Russell501/CDE2310_Group1/mechanical/Turtlebot Center of Mass.xlsx

Group 1: Alexander Yaw Kai Mun (A0306763B), Shandrico (A0305761H), Russell (A0323035U), Moksh (A0305884W)
TurtleBot3 Burger - Mass, CG & MOI Estimation
Origin: Centre of Ball Socket, at ground level. X = Back, Y = Up, Z = Left
Dimensions: 138mm (L) x 178mm (W) x 192mm (H) | Includes Self-Made Payload (Ramp + Launcher + Camera)
No. | Part Name | Qty | Unit Mass (g) | Total Mass (g) | CG X (mm) | CG Y (mm) | CG Z (mm) | Mass*X (g.mm) | Mass*Y (g.mm) | Mass*Z (g.mm) | Top View | Isometric View
1 | Waffle Plate (Layer 1 - Base) with fasteners | 1 | 138.12 | 138.12 | -49.00 | 11.12 | 0.00 | -6767.88 | 1535.89 | 0.00
2 | Waffle Plate (Layer 2) with fasteners | 1 | 138.12 | 138.12 | -49.00 | 48.44 | 0.00 | -6767.88 | 6690.53 | 0.00
3 | Waffle Plate (Layer 3) with fasteners | 1 | 138.12 | 138.12 | -49.00 | 95.22 | 0.00 | -6767.88 | 13151.79 | 0.00
4 | Waffle Plate (Layer 4 - Top) fasteners | 1 | 138.12 | 138.12 | -49.00 | 142.02 | 0.00 | -6767.88 | 19615.80 | 0.00
5 | Dynamixel XL430-W250 (Left Motor) | 1 | 16.00 | 16.00 | -69.00 | 29.08 | 52.67 | -1104.00 | 465.28 | 842.72
6 | Dynamixel XL430-W250 (Right Motor) | 1 | 16.00 | 16.00 | -69.00 | 28.54 | -52.67 | -1104.00 | 456.64 | -842.72
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
