Russell501/CDE2310_Group1/mechanical/CAD Files/flywheel launcher.SLDASM

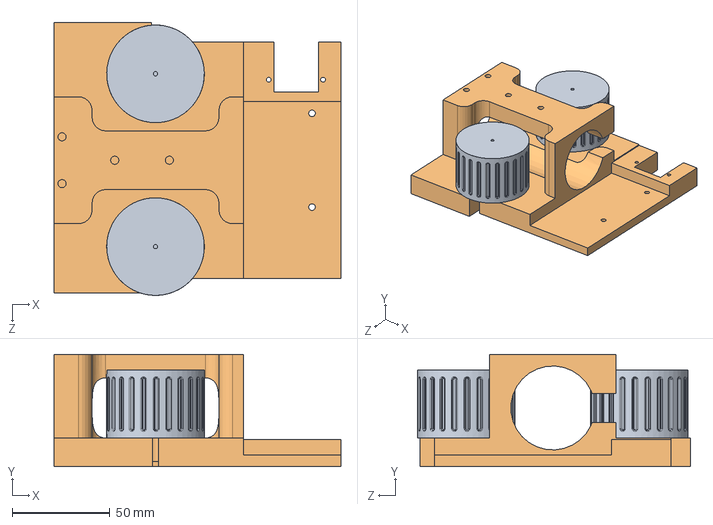
[picture p16: CAD file, 2026-04-18]
mechanical/CAD Files/flywheel launcher.SLDASM
147.0 x 57.6 x 139.7 mm
Barrel Guide
50 mm flywheel x 2
