Russell501/CDE2310_Group1/mechanical/CAD Files/Cam V2.1 v1.step

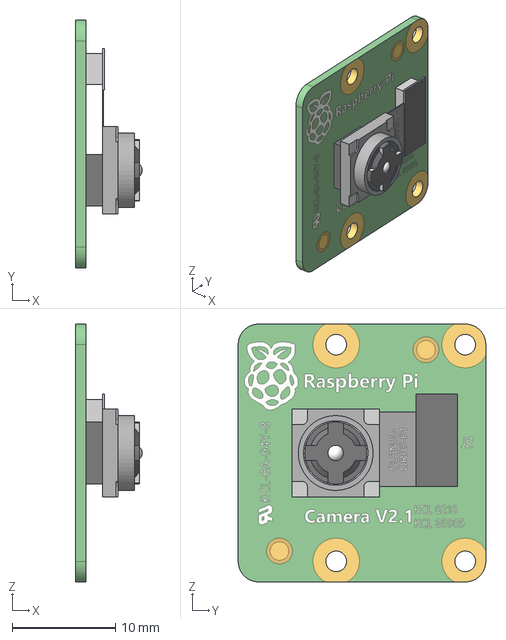
[picture p17: CAD file, 2026-04-19]
mechanical/CAD Files/Cam V2.1 v1.step
6.45 x 24.0 x 25.0 mm
