Russell501/CDE2310_Group1/mechanical/CAD Files/TurtleBot Files/Waffle Plate/Waffle Plate.SLDPRT

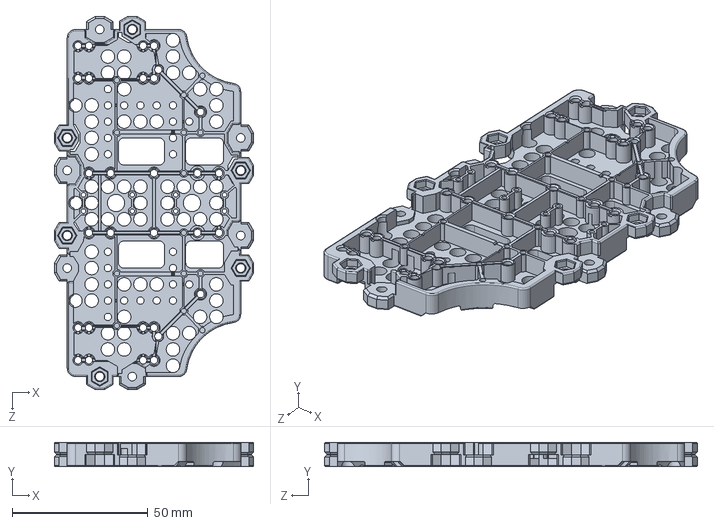
[picture p18: CAD file, 2026-04-18]
mechanical/CAD Files/TurtleBot Files/Waffle Plate/Waffle Plate.SLDPRT
73.5 x 9.00 x 137.5 mm
