Russell501/CDE2310_Group1/mechanical/CAD Files/RPi_Cam_Holder.SLDPRT

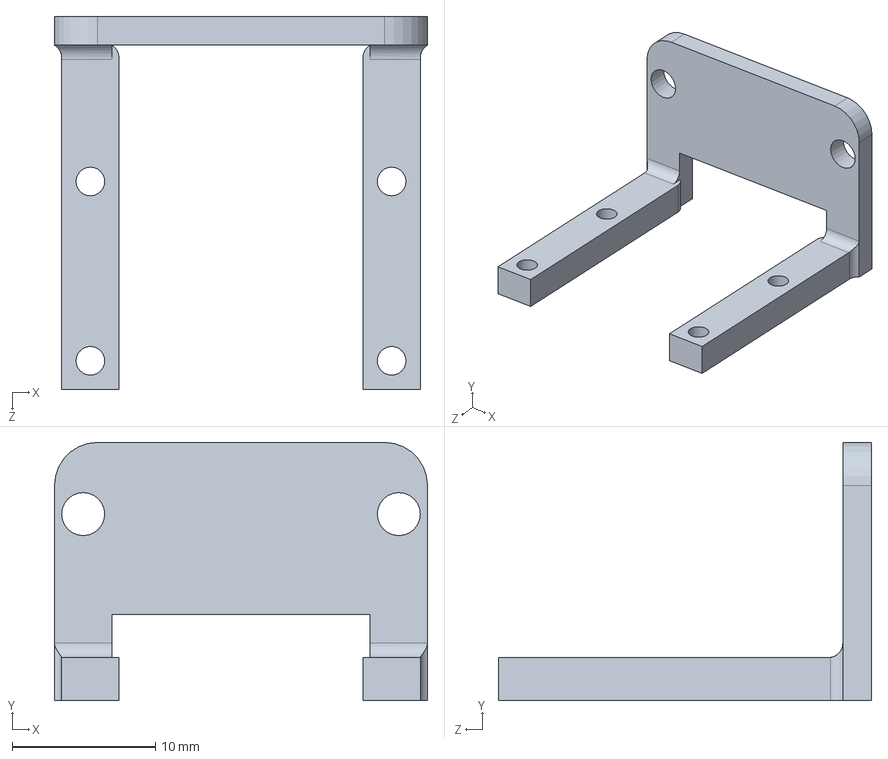
[picture p19: CAD file, 2026-04-19]
mechanical/CAD Files/RPi_Cam_Holder.SLDPRT
26.0 x 18.0 x 26.0 mm
