Russell501/CDE2310_Group1/mechanical/CAD Files/50 mm flywheel.SLDPRT

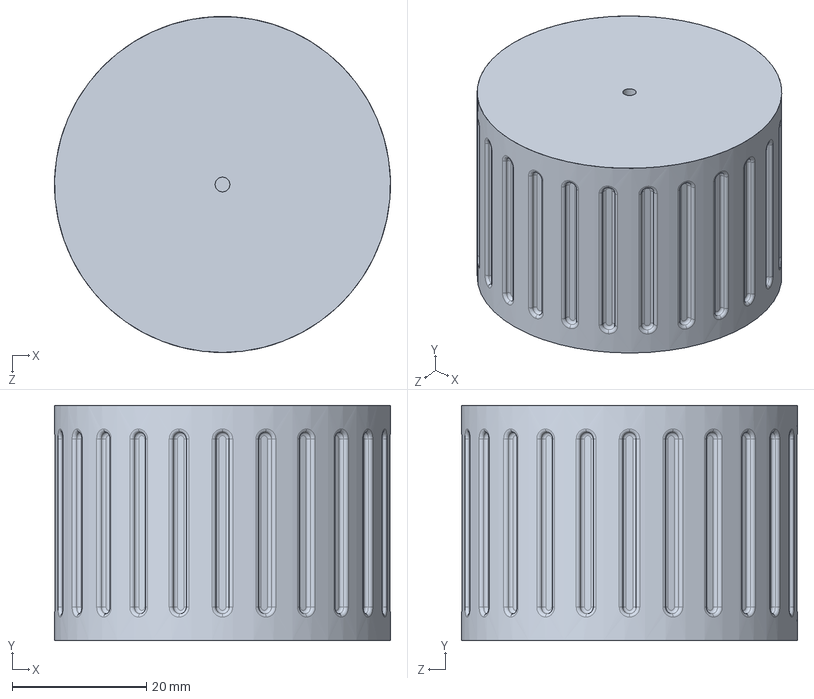
[picture p20: CAD file, 2026-04-18]
mechanical/CAD Files/50 mm flywheel.SLDPRT
50.0 x 35.0 x 50.0 mm
