Russell501/CDE2310_Group1/mechanical/CAD Files/Barrel Guide.SLDPRT

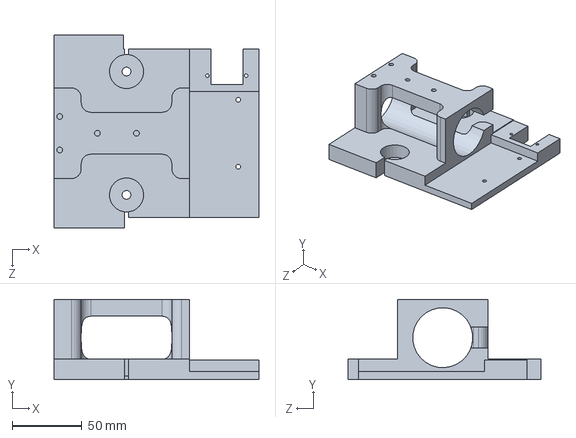
[picture p21: CAD file, 2026-04-18]
mechanical/CAD Files/Barrel Guide.SLDPRT
147.0 x 57.6 x 138.5 mm
