Russell501/CDE2310_Group1/mechanical/CAD Files/TurtleBot Files/Fasteners, Supports and Brackets/m3-x-48-x-50-threaded-insert-v5.step

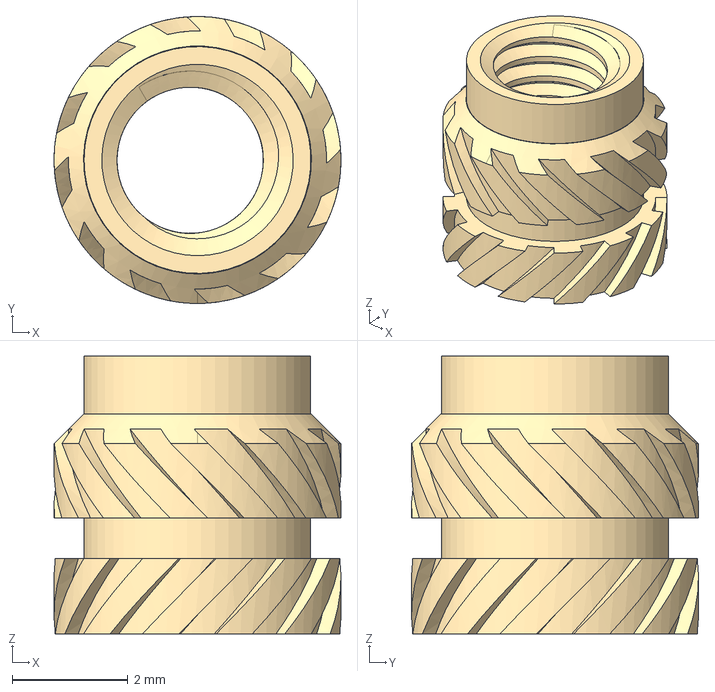
[picture p22: CAD file, 2026-04-18]
mechanical/CAD Files/TurtleBot Files/Fasteners, Supports and Brackets/m3-x-48-x-50-threaded-insert-v5.step
4.96 x 4.96 x 4.80 mm
