Russell501/CDE2310_Group1/mechanical/CAD Files/Ball Storage.SLDPRT

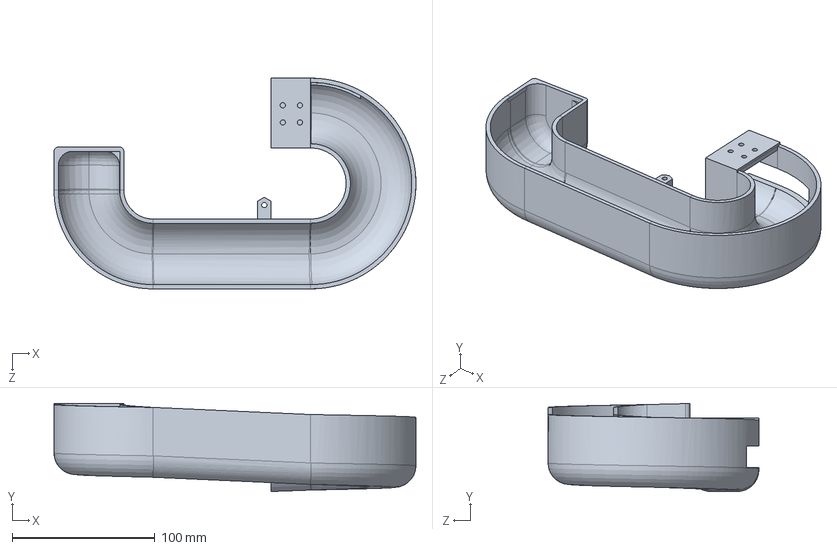
[picture p23: CAD file, 2026-04-18]
mechanical/CAD Files/Ball Storage.SLDPRT
253.9 x 61.8 x 147.9 mm
