Russell501/CDE2310_Group1/mechanical/CAD Files/Feeder Roller.SLDPRT

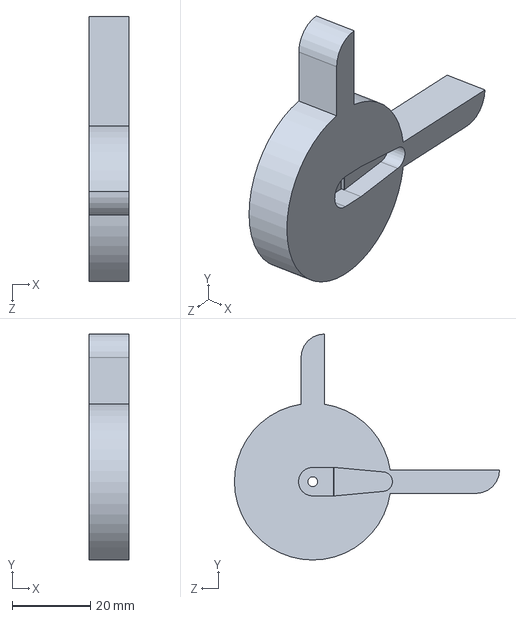
[picture p24: CAD file, 2026-04-18]
mechanical/CAD Files/Feeder Roller.SLDPRT
10.1 x 57.7 x 67.7 mm
