Russell501/CDE2310_Group1/mechanical/CAD Files/TurtleBot Files/First Floor _1_.SLDASM

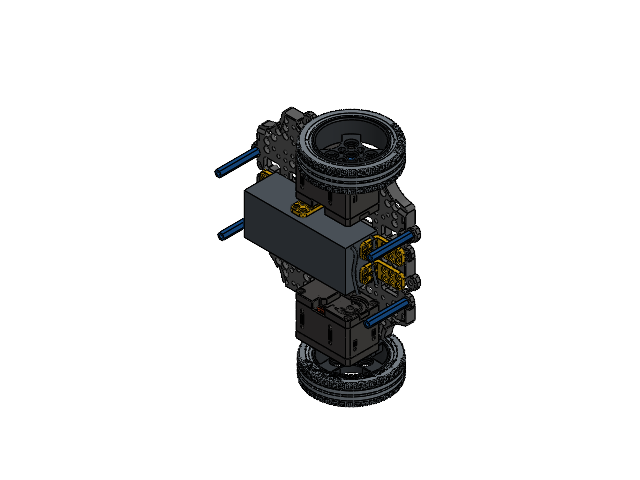
[picture p25: CAD file, 2026-04-18]
mechanical/CAD Files/TurtleBot Files/First Floor _1_.SLDASM
STEELBALL_3_8INCH
PR21_CASTER_CVR_3X5_REV6
PR16_A01_TIRE_2 x 2
P30_ISP_A001_3D x 2
Waffle Plate x 2
PHS_M2_5X8.ipt x 4
NUT2_M3 x 4
M_PR07_A01_BRACKET_2 x 5
SUPPORT_HEX_M3_0XL35_FF x 4
LB-012
