Russell501/CDE2310_Group1/mechanical/CAD Files/TurtleBot Files/Connected Plates/connected plates _1_.SLDASM

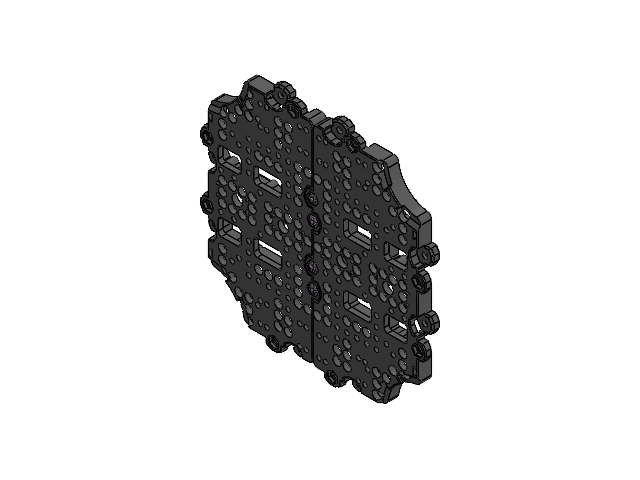
[picture p26: CAD file, 2026-04-18]
mechanical/CAD Files/TurtleBot Files/Connected Plates/connected plates _1_.SLDASM
PHS_M3X6 x 4
NUT2_M3 x 4
Waffle Plate x 2
