Russell501/CDE2310_Group1/mechanical/CAD Files/TurtleBot Files/Second Floor _1_.SLDASM

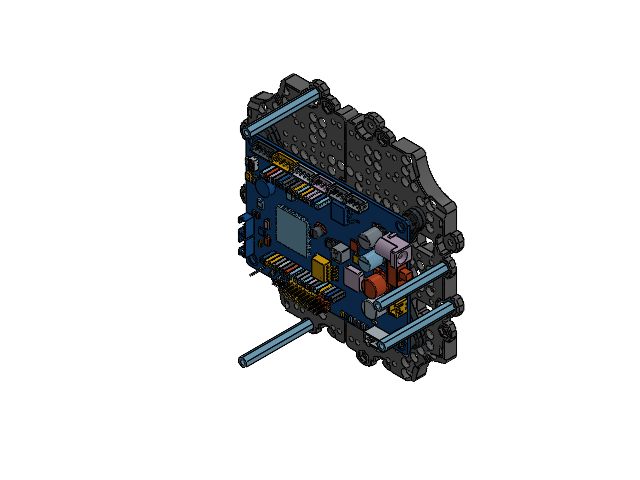
[picture p27: CAD file, 2026-04-18]
mechanical/CAD Files/TurtleBot Files/Second Floor _1_.SLDASM
MANIFOLD_SOLID_BREP_33102
MANIFOLD_SOLID_BREP_33062
MANIFOLD_SOLID_BREP_33072
MANIFOLD_SOLID_BREP_33172
MANIFOLD_SOLID_BREP_33254
USER_LIBRARY-8-VSON_5X6_U-33209
MANIFOLD_SOLID_BREP_33253
MANIFOLD_SOLID_BREP_33044
USER_LIBRARY-WE-DD-L_PIN_-33142
MANIFOLD_SOLID_BREP_33042
MANIFOLD_SOLID_BREP_33061
MANIFOLD_SOLID_BREP_33086
MANIFOLD_SOLID_BREP_33073
MANIFOLD_SOLID_BREP_33056
MANIFOLD_SOLID_BREP_33103
MANIFOLD_SOLID_BREP_33291
50MIL_HEADER_BODY-33296
MANIFOLD_SOLID_BREP_33263
50MIL_HEADER_BODY-33231
USER_LIBRARY-8-VSON_5X6_U-33206
MANIFOLD_SOLID_BREP_33134
MANIFOLD_SOLID_BREP_33091
MANIFOLD_SOLID_BREP_33100
MANIFOLD_SOLID_BREP_33087
MANIFOLD_SOLID_BREP_33063
MANIFOLD_SOLID_BREP_33098
MANIFOLD_SOLID_BREP_33292
MANIFOLD_SOLID_BREP_33203
MANIFOLD_SOLID_BREP_33104
MANIFOLD_SOLID_BREP_33069
MANIFOLD_SOLID_BREP_33064
50MIL_HEADER_BODY-33224
PIN-33146
MANIFOLD_SOLID_BREP_33288
MANIFOLD_SOLID_BREP_33257
50MIL_HEADER_BODY-33149
PINN-33307
MANIFOLD_SOLID_BREP_33161
MANIFOLD_SOLID_BREP_33055
PIN-33249
IMPORTED1-33207
PIN-33235
PIN-33228
MANIFOLD_SOLID_BREP_33168
MANIFOLD_SOLID_BREP_33047
MANIFOLD_SOLID_BREP_33132
MANIFOLD_SOLID_BREP_33093
MANIFOLD_SOLID_BREP_33144
MANIFOLD_SOLID_BREP_33260
USER_LIBRARY-8-VSON_5X6_U-33202
MANIFOLD_SOLID_BREP_33244
MANIFOLD_SOLID_BREP_33123
MANIFOLD_SOLID_BREP_33048
MANIFOLD_SOLID_BREP_33262
USER_LIBRARY-8-VSON_5X6_U-33208
MANIFOLD_SOLID_BREP_33054
MANIFOLD_SOLID_BREP_33059
MANIFOLD_SOLID_BREP_33227
USER_LIBRARY-8-VSON_5X6_U-33105
MANIFOLD_SOLID_BREP_33092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
