Russell501/CDE2310_Group1/(list of files, cad)

Other CAD files:
mechanical/CAD Files/TurtleBot Files/Connected Plates/connected plates _1_-2.SLDASM
mechanical/CAD Files/TurtleBot Files/TurtleBot3 Burger(2).SLDASM
mechanical/CAD Files/TurtleBot Files/Wheels/wheel _2_.SLDASM
mechanical/CAD Files/TurtleBot Files/Ball Caster/ball_caster _1_.SLDASM
mechanical/CAD Files/TurtleBot Files/Connected Plates/connected plates _1_-1.SLDASM
mechanical/CAD Files/TurtleBot Files/Wheels/wheel _1_.SLDASM
mechanical/CAD Files/TurtleBot Files/Connected Plates/connected plates _1_-3.SLDASM
mechanical/CAD Files/TurtleBot Files/USB2LDS/USB2LDS _1_.SLDASM
mechanical/CAD Files/TurtleBot Files/Open CR/OPENCR _1_.SLDASM
mechanical/CAD Files/TurtleBot Files/LiDAR/LDS _1_.SLDASM
mechanical/CAD Files/TurtleBot Files/Ball Caster/STEELBALL_3_8INCH.SLDPRT
mechanical/CAD Files/TurtleBot Files/Fasteners, Supports and Brackets/SUPPORT_HEX_M3_0XL45_FF.SLDPRT
mechanical/CAD Files/TurtleBot Files/LiDAR/LDS_ONSHAPE-422.SLDPRT
mechanical/CAD Files/TurtleBot Files/Open CR/PIN-33235.SLDPRT
mechanical/CAD Files/TurtleBot Files/RPi/Part 8.SLDPRT
mechanical/CAD Files/TurtleBot Files/USB2LDS/MICRO_USB-5.SLDPRT
mechanical/CAD Files/TurtleBot Files/Wheels/P30_ISP_A001_3D.SLDPRT
mechanical/CAD Files/TurtleBot Files/Ball Caster/PR21_CASTER_CVR_3X5_REV6.SLDPRT
mechanical/CAD Files/TurtleBot Files/Fasteners, Supports and Brackets/PHS_M2_5X12.SLDPRT
mechanical/CAD Files/TurtleBot Files/LiDAR/LDS_ONSHAPE-1296.SLDPRT
mechanical/CAD Files/TurtleBot Files/Open CR/MANIFOLD_SOLID_BREP_33157.SLDPRT
mechanical/CAD Files/TurtleBot Files/RPi/Part 27.SLDPRT
mechanical/CAD Files/TurtleBot Files/USB2LDS/MICRO_USB-8.SLDPRT
mechanical/CAD Files/TurtleBot Files/Fasteners, Supports and Brackets/SUPPORT_HEX_M3_0XL35_FF.SLDPRT
mechanical/CAD Files/TurtleBot Files/LB-012.SLDPRT
mechanical/CAD Files/TurtleBot Files/LiDAR/LDS_ONSHAPE-290.SLDPRT
mechanical/CAD Files/TurtleBot Files/Open CR/MANIFOLD_SOLID_BREP_33152.SLDPRT
mechanical/CAD Files/TurtleBot Files/RPi/Surface 34.SLDPRT
mechanical/CAD Files/TurtleBot Files/USB2LDS/BIC04_C01_PCB.SLDPRT
mechanical/CAD Files/TurtleBot Files/Fasteners, Supports and Brackets/PHS_M3X6.SLDPRT
mechanical/CAD Files/TurtleBot Files/LiDAR/LDS_ONSHAPE-1481.SLDPRT
mechanical/CAD Files/TurtleBot Files/Open CR/PIN-33293.SLDPRT
mechanical/CAD Files/TurtleBot Files/RPi/Surface 14.SLDPRT
mechanical/CAD Files/TurtleBot Files/USB2LDS/MICRO_USB-3.SLDPRT
mechanical/CAD Files/TurtleBot Files/Wheels/PR16_A01_TIRE_2.SLDPRT
mechanical/CAD Files/TurtleBot Files/LiDAR/LDS_ONSHAPE-361.SLDPRT
mechanical/CAD Files/TurtleBot Files/Open CR/3-33245.SLDPRT
mechanical/CAD Files/TurtleBot Files/RPi/Part 30.SLDPRT
mechanical/CAD Files/TurtleBot Files/USB2LDS/MICRO_USB.SLDPRT
mechanical/CAD Files/SG90 - Micro Servo 9g - Tower Pro.5-1.SLDPRT
mechanical/CAD Files/TurtleBot Files/Fasteners, Supports and Brackets/SUPPORT_HEX_M3_0XL45_FF-9.SLDPRT
mechanical/CAD Files/TurtleBot Files/LiDAR/LDS_ONSHAPE-1818.SLDPRT
mechanical/CAD Files/TurtleBot Files/Open CR/MANIFOLD_SOLID_BREP_33256.SLDPRT
mechanical/CAD Files/TurtleBot Files/RPi/Part 1.SLDPRT
mechanical/CAD Files/TurtleBot Files/USB2LDS/MICRO_USB-7.SLDPRT
mechanical/CAD Files/TurtleBot Files/Fasteners, Supports and Brackets/PHS_M3X6-1.SLDPRT
mechanical/CAD Files/TurtleBot Files/LiDAR/LDS_ONSHAPE-1070.SLDPRT
mechanical/CAD Files/TurtleBot Files/Open CR/MANIFOLD_SOLID_BREP_33290.SLDPRT
mechanical/CAD Files/TurtleBot Files/RPi/Part 26.SLDPRT
mechanical/CAD Files/TurtleBot Files/USB2LDS/MICRO_USB-4.SLDPRT
mechanical/CAD Files/TurtleBot Files/Fasteners, Supports and Brackets/PHS_M2_5X12-11.SLDPRT
mechanical/CAD Files/TurtleBot Files/LiDAR/LDS_ONSHAPE-1809.SLDPRT
mechanical/CAD Files/TurtleBot Files/Open CR/50MIL_HEADER_BODY-33294.SLDPRT
mechanical/CAD Files/TurtleBot Files/RPi/Surface 4.SLDPRT
mechanical/CAD Files/TurtleBot Files/Fasteners, Supports and Brackets/PR30_IBB_01_3D.SLDPRT
mechanical/CAD Files/TurtleBot Files/LiDAR/LDS_ONSHAPE-2016.SLDPRT
mechanical/CAD Files/TurtleBot Files/Open CR/MANIFOLD_SOLID_BREP_33082.SLDPRT
mechanical/CAD Files/TurtleBot Files/RPi/Surface 10.SLDPRT
mechanical/CAD Files/TurtleBot Files/Fasteners, Supports and Brackets/NUT2_M3-2.SLDPRT
mechanical/CAD Files/TurtleBot Files/LiDAR/LDS_ONSHAPE-1489.SLDPRT
mechanical/CAD Files/TurtleBot Files/Open CR/MANIFOLD_SOLID_BREP_33123.SLDPRT
mechanical/CAD Files/TurtleBot Files/RPi/Part 19.SLDPRT
mechanical/CAD Files/TurtleBot Files/USB2LDS/MICRO_USB-6.SLDPRT
mechanical/CAD Files/TurtleBot Files/Fasteners, Supports and Brackets/NUT2_M3.SLDPRT
mechanical/CAD Files/TurtleBot Files/LiDAR/LDS_ONSHAPE-1281.SLDPRT
mechanical/CAD Files/TurtleBot Files/Open CR/MANIFOLD_SOLID_BREP_33281.SLDPRT
mechanical/CAD Files/TurtleBot Files/RPi/Surface 8.SLDPRT
mechanical/CAD Files/TurtleBot Files/Fasteners, Supports and Brackets/PR30_IBB_01_3D-10.SLDPRT
mechanical/CAD Files/TurtleBot Files/LiDAR/LDS_ONSHAPE-1783.SLDPRT
mechanical/CAD Files/TurtleBot Files/RPi/Part 22.SLDPRT
mechanical/CAD Files/TurtleBot Files/LiDAR/LDS_ONSHAPE-539.SLDPRT
mechanical/CAD Files/TurtleBot Files/Open CR/MANIFOLD_SOLID_BREP_33080.SLDPRT
mechanical/CAD Files/TurtleBot Files/RPi/Surface 9.SLDPRT
mechanical/CAD Files/TurtleBot Files/LiDAR/LDS_ONSHAPE-1448.SLDPRT
mechanical/CAD Files/TurtleBot Files/Open CR/3-33196.SLDPRT
mechanical/CAD Files/TurtleBot Files/RPi/Surface 6.SLDPRT
mechanical/CAD Files/TurtleBot Files/LiDAR/LDS_ONSHAPE-2088.SLDPRT
mechanical/CAD Files/TurtleBot Files/Open CR/MANIFOLD_SOLID_BREP_33077.SLDPRT
mechanical/CAD Files/TurtleBot Files/RPi/Surface 22.SLDPRT
mechanical/CAD Files/TurtleBot Files/LiDAR/LDS_ONSHAPE-998.SLDPRT
mechanical/CAD Files/TurtleBot Files/Open CR/USER_LIBRARY-8-VSON_5X6_U-33111.SLDPRT
mechanical/CAD Files/TurtleBot Files/RPi/Surface 27.SLDPRT
mechanical/CAD Files/TurtleBot Files/LiDAR/LDS_ONSHAPE-451.SLDPRT
mechanical/CAD Files/TurtleBot Files/Open CR/MANIFOLD_SOLID_BREP_33278.SLDPRT
mechanical/CAD Files/TurtleBot Files/RPi/Surface 5.SLDPRT
mechanical/CAD Files/TurtleBot Files/LiDAR/LDS_ONSHAPE-626.SLDPRT
mechanical/CAD Files/TurtleBot Files/Open CR/MANIFOLD_SOLID_BREP_33230.SLDPRT
mechanical/CAD Files/TurtleBot Files/RPi/Part 14.SLDPRT
mechanical/CAD Files/TurtleBot Files/LiDAR/LDS_ONSHAPE-1638.SLDPRT
mechanical/CAD Files/TurtleBot Files/Open CR/MANIFOLD_SOLID_BREP_33048.SLDPRT
mechanical/CAD Files/TurtleBot Files/RPi/Part 1-14.SLDPRT
mechanical/CAD Files/TurtleBot Files/LiDAR/LDS_ONSHAPE-1583.SLDPRT
mechanical/CAD Files/TurtleBot Files/Open CR/MANIFOLD_SOLID_BREP_33049.SLDPRT
mechanical/CAD Files/TurtleBot Files/RPi/Part 32.SLDPRT
mechanical/CAD Files/TurtleBot Files/LiDAR/LDS_ONSHAPE-1796.SLDPRT
mechanical/CAD Files/TurtleBot Files/Open CR/PIN-33297.SLDPRT
mechanical/CAD Files/TurtleBot Files/RPi/Part 11.SLDPRT
mechanical/CAD Files/TurtleBot Files/LiDAR/LDS_ONSHAPE-1214.SLDPRT
mechanical/CAD Files/TurtleBot Files/Open CR/MANIFOLD_SOLID_BREP_33280.SLDPRT
mechanical/CAD Files/TurtleBot Files/RPi/Part 6.SLDPRT
mechanical/CAD Files/TurtleBot Files/LiDAR/LDS_ONSHAPE-893.SLDPRT
mechanical/CAD Files/TurtleBot Files/Open CR/MANIFOLD_SOLID_BREP_33065.SLDPRT
mechanical/CAD Files/TurtleBot Files/RPi/Surface 36.SLDPRT
mechanical/CAD Files/TurtleBot Files/LiDAR/LDS_ONSHAPE-55.SLDPRT
mechanical/CAD Files/TurtleBot Files/Open CR/MANIFOLD_SOLID_BREP_33173.SLDPRT
mechanical/CAD Files/TurtleBot Files/RPi/Part 18.SLDPRT
mechanical/CAD Files/TurtleBot Files/LiDAR/LDS_ONSHAPE-742.SLDPRT
mechanical/CAD Files/TurtleBot Files/Open CR/USER_LIBRARY-8-VSON_5X6_U-33202.SLDPRT
mechanical/CAD Files/TurtleBot Files/RPi/Surface 2.SLDPRT
mechanical/CAD Files/TurtleBot Files/LiDAR/LDS_ONSHAPE-1727.SLDPRT
mechanical/CAD Files/TurtleBot Files/Open CR/IMPORTED1-33180.SLDPRT
mechanical/CAD Files/TurtleBot Files/RPi/Part 5.SLDPRT
mechanical/CAD Files/TurtleBot Files/LiDAR/LDS_ONSHAPE-103.SLDPRT
mechanical/CAD Files/TurtleBot Files/Open CR/USER_LIBRARY-8-VSON_5X6_U-33208.SLDPRT
mechanical/CAD Files/TurtleBot Files/RPi/Surface 18.SLDPRT
mechanical/CAD Files/TurtleBot Files/LiDAR/LDS_ONSHAPE-636.SLDPRT
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
