Russell501/CDE2310_Group1/(commit log)

2026-04-07 docs(payload): Added the centre of mass calculation file
    [Centre_of_Mass_Calculation.xlsx]
2026-04-10 Reformat file structure: Make it more similar to the actual file structure on the operational machine
    [common_properties.urdf, model-1_4.sdf, model-1_4_.sdf, model.sdf, turtlebot3_burger.urdf, turtlebot3_waffle.urdf, turtlebot3_waffle_pi.urdf]
2026-04-11 Rename Software file to lower case for convention
2026-04-11 Update docking logic: Uses stored aruco location to navigate to the general area, then uses live camera feed for actual precise docking
2026-04-12 Update Station A docking logic: Visual servo and approach
2026-04-12 Reconfigure visual servo so it is the same for both Station A and B
2026-04-14 Add edge case handling: If Station A is found while docking with Station B
2026-04-17 added subfolders for turtlebot cad files
2026-04-17 added USB2LDS CAD Files
    [530480810.SLDPRT, BIC04_C01_PCB.SLDPRT, MICRO_USB-3.SLDPRT, MICRO_USB-4.SLDPRT, MICRO_USB-5.SLDPRT, MICRO_USB-6.SLDPRT, MICRO_USB-7.SLDPRT, MICRO_USB-8.SLDPRT]
2026-04-17 Rename CAD Files/TurtleBot Files to CAD Files
2026-04-17 Rename TurtleBot Files/USB2LDS to USB2LDS
    [micro usb.ipt]
2026-04-17 Move micro usb.ipt to TurtleBot directory
    [micro usb.ipt]
2026-04-17 uploaded rpi cad files
    [Part 1-14.SLDPRT, Part 1.SLDPRT, Part 10.SLDPRT, Part 11.SLDPRT, Part 12.SLDPRT, Part 13.SLDPRT, Part 14.SLDPRT, Part 15.SLDPRT]
2026-04-17 uploaded flyhweel part file
    [50 mm flywheel.SLDPRT]
2026-04-17 Moved flywheel file into CAD Files directory
    [50 mm flywheel.SLDPRT]
2026-04-17 uploaded ball storage part file
    [Ball Storage.SLDPRT]
2026-04-17 uploaded flywheel housing part file into CAD Files
    [Flywheel Housing.SLDPRT]
2026-04-17 uploaded feeder roller to CAD Files folder
    [Feeder Roller.SLDPRT]
2026-04-17 uploaded updated waffle plate from canvas
    [Waffle Plate.SLDPRT, Waffle Plate.ipt]
2026-04-17 Rename Flywheel Housing.SLDPRT to Barrel Guide.SLDPRT
    [Barrel Guide.SLDPRT]
2026-04-17 uploaded flywheel launcher assembly file
    [flywheel launcher.SLDASM]
2026-04-17 uploaded open cr files
    [022035025.SLDPRT, 1-33154.SLDPRT, 1-33162.SLDPRT, 1-33193.SLDPRT, 1-33242.SLDPRT, 2-33160.SLDPRT, 2-33170.SLDPRT, 2-33199.SLDPRT]
2026-04-17 added LiDAR part files
    [LDS _1_.SLDASM, LDS_ONSHAPE-100.SLDPRT, LDS_ONSHAPE-1000.SLDPRT, LDS_ONSHAPE-1001.SLDPRT, LDS_ONSHAPE-1002.SLDPRT, LDS_ONSHAPE-1003.SLDPRT, LDS_ONSHAPE-1004.SLDPRT, LDS_ONSHAPE-1005.SLDPRT]
2026-04-17 uploaded ball caster cad files
    [PR21_CASTER_CVR_3X5_REV6.SLDPRT, STEELBALL_3_8INCH.SLDPRT, ball_caster _1_.SLDASM]
2026-04-17 uploaded wheels cad files
    [P30_ISP_A001_3D.SLDPRT, P30_ISP_A001_3D_Sprocket Wheel.ipt, PR16_A01_TIRE_2.SLDPRT, PR16_A01_TIRE_2.ipt, wheel _1_.SLDASM, wheel _2_.SLDASM]
2026-04-17 uploaded connected layer
    [connected plates _1_-1.SLDASM, connected plates _1_-2.SLDASM, connected plates _1_-3.SLDASM, connected plates _1_.SLDASM]
2026-04-17 uploaded first to fourth layer assembly
    [First Floor _1_.SLDASM, Second Floor _1_.SLDASM]
2026-04-17 uploaded servo sg90 cad file
    [SG90 - Micro Servo 9g - Tower Pro.5-1.SLDPRT]
2026-04-17 uploaded turtlebot battery cad model
    [LB-012.SLDPRT]
2026-04-17 uploaded fasteners, supports and bracket
    [NUT2_M3-2.SLDPRT, NUT2_M3.SLDPRT, PHS_M2_5X12-11.SLDPRT, PHS_M2_5X12.SLDPRT, PHS_M3X6-1.SLDPRT, PHS_M3X6.SLDPRT, PR30_IBB_01_3D-10.SLDPRT, PR30_IBB_01_3D.SLDPRT]
2026-04-17 uploaded default turtlebot assembly
    [TurtleBot3 Burger(2).SLDASM]
2026-04-17 uploaded modified turtlebot assembly
2026-04-18 Added Mechanical system Documentation
    Added detailed mechanical documentation for TurtleBot Group 1, including components, assembly instructions, system specifications, and design reasoning.
2026-04-18 updated center of mass calculation
    [Centre_of_Mass_Calculation.xlsx, Turtlebot Center of Mass.xlsx]
2026-04-18 Updated servo installation instructions
2026-04-19 Updated Turtlebot Cad assembly to newest version
2026-04-19 Add servo moving script
2026-04-19 Add BOM
2026-04-19 Update BOM
2026-04-19 Added more printed materials to BOM
2026-04-19 Update pages to include link to BOM
2026-04-19 Update BOM navigation section
2026-04-19 Update assembly isntructions
2026-04-19 Change mechnical folder naming to lowercase for convention
    [022035025.SLDPRT, 1-33154.SLDPRT, 1-33162.SLDPRT, 1-33193.SLDPRT, 1-33242.SLDPRT, 2-33160.SLDPRT, 2-33170.SLDPRT, 2-33199.SLDPRT]
2026-04-19 added rpi cam holder
    [RPi_Cam_Holder.SLDPRT]
2026-04-19 added RPi Cam cad model
    [Cam V2.1 v1.step]
2026-04-19 Update BOM Navigation segment
2026-04-19 Edit assembly pictures in mechanical.md
